Quphoria/PicoDrive/PicoDrive Labelled.png

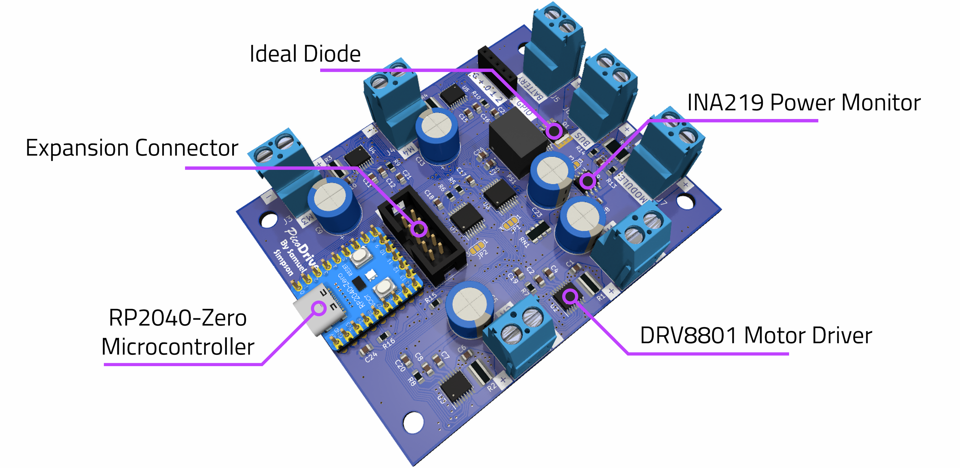
PicoDrive Labelled.png
