Quphoria/PicoDrive/PicoDrive Dark Labelled.png

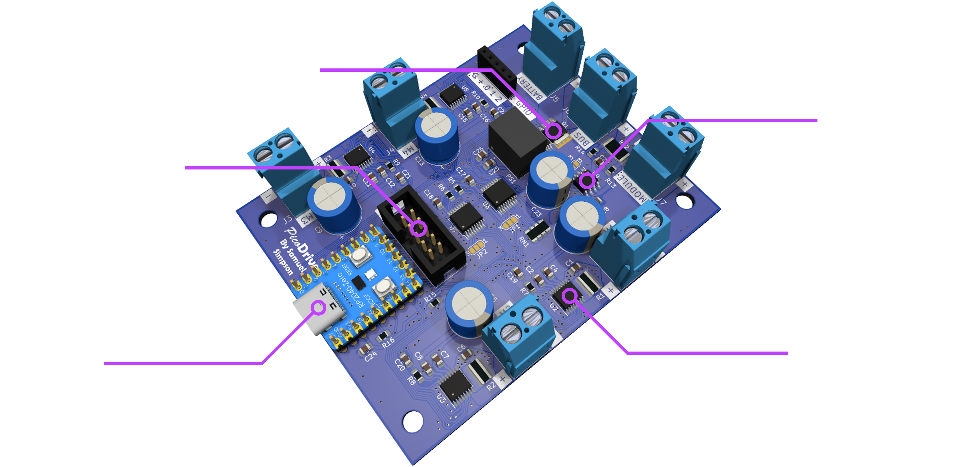
PicoDrive Dark Labelled.png
