Quphoria/PicoDrive/PicoDrive.png

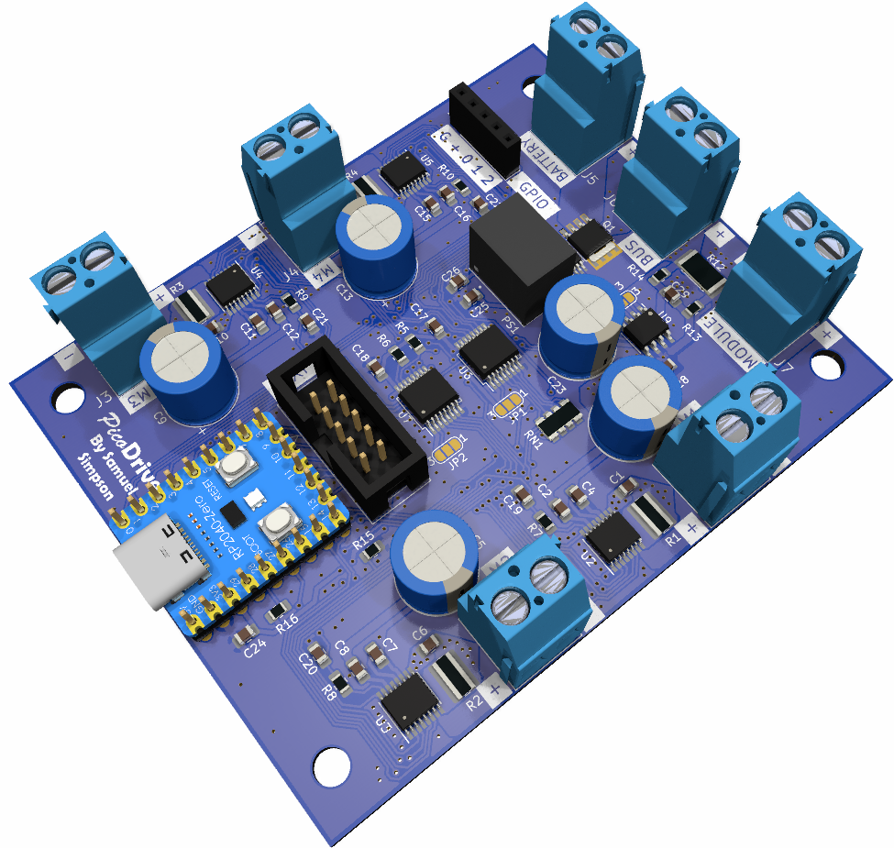
PicoDrive.png
