Quphoria/PicoDrive/PicoDrive.kicad_pcb

## KiCad design PicoDrive.kicad_pcb (2024-04-17)

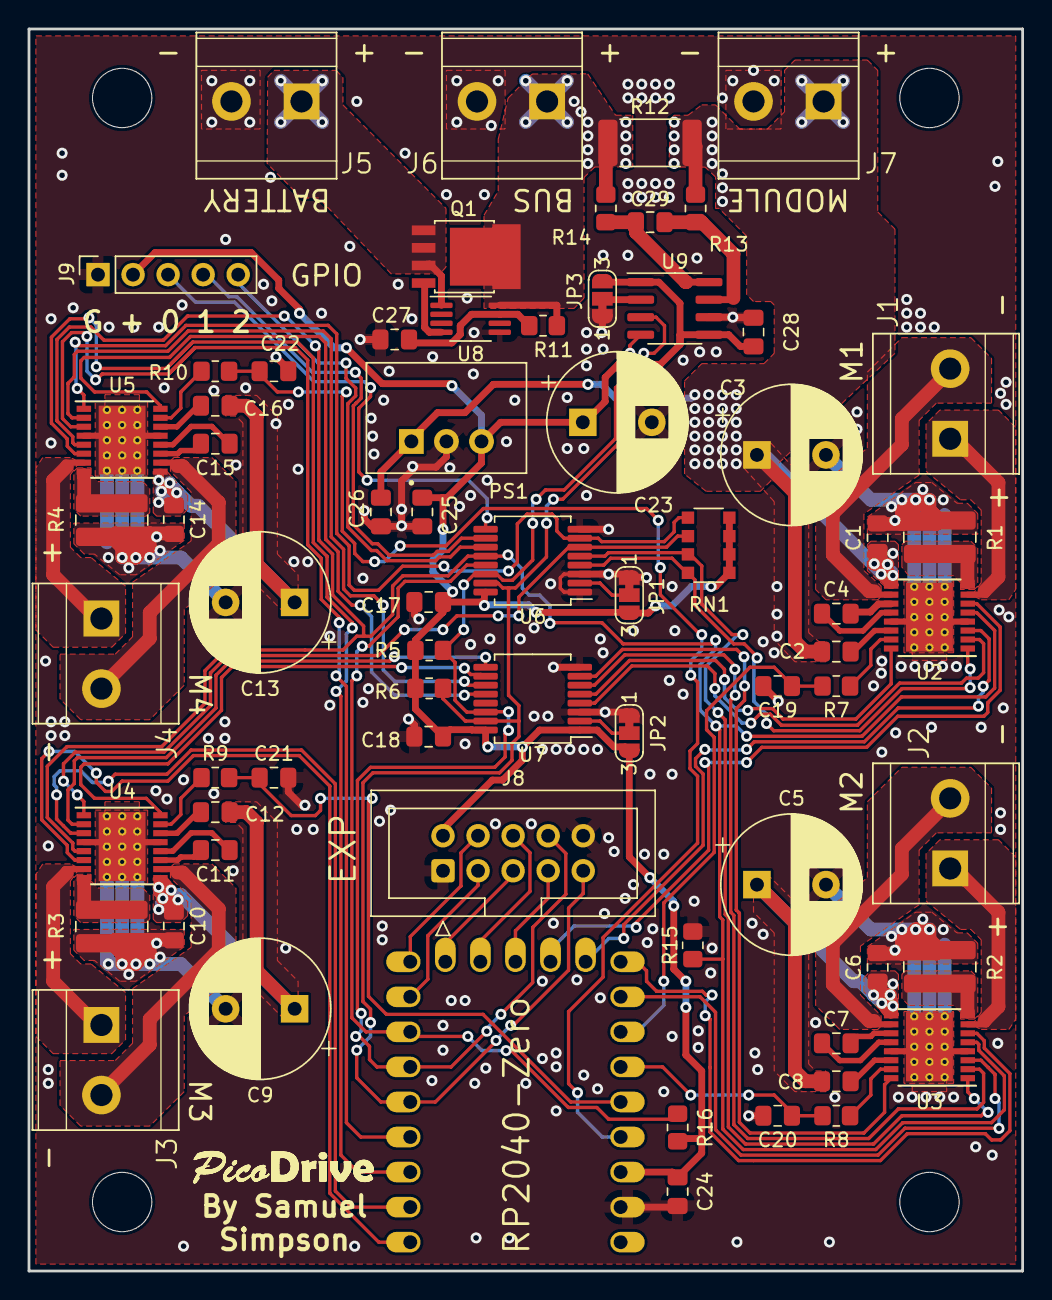
[picture p4: board PicoDrive.kicad_pcb from above]

Board: 2 copper layers, 72.0 x 90.0 mm, 73 parts (0 on the bottom side), 76 nets.

Parts:
C1, C2, C4, C6, C7, C8, C10, C11, C12, C14, C15, C16, C17, C18, C24, C25, C26, C27, C28, C29: 0.1uF; C_0805_2012Metric_Pad1.18x1.45mm_HandSolder
C3, C5, C9, C13, C23: 100uF; CP_Radial_D10.0mm_P5.00mm
C19, C20, C21, C22: 1000pF; C_0805_2012Metric_Pad1.18x1.45mm_HandSolder
H1, H2, H3, H4: MountingHole; MountingHole_4.3mm_M4
J1, J2, J3, J4, J5, J6, J7: Conn_01x02; CUI_TB009-508-02BE
J8: Conn_02x05_Odd_Even; IDC-Header_2x05_P2.54mm_Vertical
J9: Conn_01x05; PinSocket_1x05_P2.54mm_Vertical
JP1, JP2, JP3: SolderJumper_3_Bridged12; SolderJumper-3_P1.3mm_Bridged12_RoundedPad1.0x1.5mm_NumberL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
PS1: P78E03-1000; CONV_P78E03-1000
Q1: PSMN4R5-30YLC; LFPAK56
R1, R2, R3, R4: 0.2; R_1020_2550Metric_Pad1.33x5.20mm_HandSolder
R5, R6: 1.65k; R_0805_2012Metric_Pad1.20x1.40mm_HandSolder
R7, R8, R9, R10, R15, R16: 10k; R_0805_2012Metric_Pad1.20x1.40mm_HandSolder
R11: 100; R_0805_2012Metric_Pad1.20x1.40mm_HandSolder
R12: 0.005; R_2512_6332Metric_Pad1.40x3.35mm_HandSolder
R13, R14: 10; R_0805_2012Metric_Pad1.20x1.40mm_HandSolder
RN1: 10k; R_Array_Convex_4x1206
U1: rp2040-zero; rp2040-zero-tht
U2, U3, U4, U5: DRV8801PWPR; HTSSOP-16-1EP_4.4x5mm_P0.65mm_EP3.4x5mm_Mask3x3mm_ThermalVi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
U6, U7: TCA9554DB; SSOP-16_5.3x6.2mm_P0.65mm
U8: LTC4357MS8; MSOP-8_3x3mm_P0.65mm
U9: INA219BIDR; SOIC-8_3.9x4.9mm_P1.27mm

Connections:
+3V3: C17.1, C18.1, C23.1, C24.2, C25.2, C28.1, J8.2, J9.2, JP1.3 (B), JP2.3 (B), JP3.3 (B), PS1.3 (+VOUT/GND), R5.2, R6.2, R16.2, RN1.1 (R1.1), RN1.2 (R2.1), RN1.3 (R3.1), RN1.4 (R4.1), U1.21 (3V3), U6.16 (VDD), U7.1 (A0), U7.16 (VDD), U9.1 (A1), U9.5 (VS)
+BATT: J5.1, Q1.1 (S), Q1.2 (S), Q1.3 (S), U8.1 (IN)
/EXP_IO_0: J9.3, U6.9 (P4)
/EXP_IO_1: J9.4, U6.10 (P5)
/EXP_IO_2: J9.5, U6.11 (P6)
/EXP_SCL: J8.8, R5.1, U1.6 (5), U6.14 (SCL), U7.14 (SCL), U9.4 (SCL)
/EXP_SDA: J8.9, R6.1, U1.5 (4), U6.15 (SDA), U7.15 (SDA), U9.3 (SDA)
/GPIO7: J8.3, U1.8 (7)
/GPIO8: J8.4, U1.9 (8)
/GPIO9: J8.5, U1.10 (9)
/GPIO10: J8.6, U1.11 (10)
/GPIO11: J8.7, U1.12 (11)
/M1_EN: U1.13 (12), U2.6 (ENABLE)
/M1_MODE1: U2.2 (MODE1), U7.4 (P0)
/M1_MODE2: U2.16 (MODE2), U7.5 (P1)
/M1_PH: U1.14 (13), U2.3 (PHASE)
/M1_VPROPI: C19.2, R7.1, U1.17 (26)
/M2_EN: U1.15 (14), U3.6 (ENABLE)
/M2_MODE1: U3.2 (MODE1), U7.6 (P2)
/M2_MODE2: U3.16 (MODE2), U7.7 (P3)
/M2_PH: U1.16 (15), U3.3 (PHASE)
/M2_VPROPI: C20.2, R8.1, U1.18 (27)
/M3_EN: U1.1 (0), U4.6 (ENABLE)
/M3_MODE1: U4.2 (MODE1), U7.9 (P4)
/M3_MODE2: U4.16 (MODE2), U7.10 (P5)
/M3_PH: U1.2 (1), U4.3 (PHASE)
/M3_VPROPI: C21.2, R9.1, U1.19 (28)
/M4_EN: U1.3 (2), U5.6 (ENABLE)
/M4_MODE1: U5.2 (MODE1), U7.11 (P6)
/M4_MODE2: U5.16 (MODE2), U7.12 (P7)
/M4_PH: U1.4 (3), U5.3 (PHASE)
/M4_VPROPI: C22.2, R10.1, U1.20 (29)
/Motor 1 Driver/OUT+: J1.1, U2.7 (OUT+)
/Motor 1 Driver/OUT-: J1.2, U2.10 (OUT-)
/Motor 1 Driver/SENSE: R1.1, U2.8 (SENSE)
/Motor 2 Driver/OUT+: J2.1, U3.7 (OUT+)
/Motor 2 Driver/OUT-: J2.2, U3.10 (OUT-)
/Motor 2 Driver/SENSE: R2.1, U3.8 (SENSE)
/Motor 3 Driver/OUT+: J3.1, U4.7 (OUT+)
/Motor 3 Driver/OUT-: J3.2, U4.10 (OUT-)
/Motor 3 Driver/SENSE: R3.1, U4.8 (SENSE)
/Motor 4 Driver/OUT+: J4.1, U5.7 (OUT+)
/Motor 4 Driver/OUT-: J4.2, U5.10 (OUT-)
/Motor 4 Driver/SENSE: R4.1, U5.8 (SENSE)
/~EXP1_INT: R16.1, U1.7 (6), U6.13 (~INT)
/~M1_FAULT: RN1.8 (R1.2), U2.1 (~FAULT), U6.4 (P0)
/~M2_FAULT: RN1.7 (R2.2), U3.1 (~FAULT), U6.5 (P1)
/~M3_FAULT: RN1.6 (R3.2), U4.1 (~FAULT), U6.6 (P2)
/~M4_FAULT: RN1.5 (R4.2), U5.1 (~FAULT), U6.7 (P3)
/~M_SLEEP: R15.1, U2.5 (~SLEEP), U3.5 (~SLEEP), U4.5 (~SLEEP), U5.5 (~SLEEP), U6.12 (P7)
GND1: C1.1, C3.2, C5.2, C6.1, C9.2, C10.1, C13.2, C14.1, C17.2, C18.2, C19.1, C20.1, C21.1, C22.1, C23.2, C24.1, C25.1, C26.2, C27.1, C28.2, J5.2, J6.2, J7.2, J8.1, J8.10, J9.1, JP1.1 (A), JP2.1 (A), JP3.1 (A), PS1.2 (GND/-VOUT), R1.2, R2.2, R3.2, R4.2, R15.2, U1.22 (GND), U2.4 (GND), U2.13 (GND), U2.17 (GND(PPAD)), U3.4 (GND), U3.13 (GND), U3.17 (GND(PPAD)), U4.4 (GND), U4.13 (GND), U4.17 (GND(PPAD)), U5.4 (GND), U5.13 (GND), U5.17 (GND(PPAD)), U6.1 (A0), U6.3 (A2), U6.8 (GND), U7.3 (A2), U7.8 (GND), U8.5 (GND), U9.6 (GND)
unnamed: JP1.2 (C), U6.2 (A1)
unnamed: JP2.2 (C), U7.2 (A1)
unnamed: JP3.2 (C), U9.2 (A0)
unnamed: Q1.4 (G), U8.4 (GATE)
unnamed: C4.2, U2.11 (CP1)
unnamed: C4.1, U2.12 (CP2)
unnamed: C2.2, U2.14 (VCP)
unnamed: R7.2, U2.15 (VPROPI)
unnamed: C7.2, U3.11 (CP1)
unnamed: C7.1, U3.12 (CP2)
unnamed: C8.2, U3.14 (VCP)
unnamed: R8.2, U3.15 (VPROPI)
unnamed: C11.2, U4.11 (CP1)
unnamed: C11.1, U4.12 (CP2)
unnamed: C12.2, U4.14 (VCP)
unnamed: R9.2, U4.15 (VPROPI)
unnamed: C15.2, U5.11 (CP1)
unnamed: C15.1, U5.12 (CP2)
unnamed: C16.2, U5.14 (VCP)
unnamed: R10.2, U5.15 (VPROPI)
unnamed: C27.2, R11.1, U8.7 (Vdd)
unnamed: C29.1, R14.2, U9.8 (IN+)
unnamed: C29.2, R13.2, U9.7 (IN-)
VBUS: J6.1, Q1.5 (D), R11.2, R12.1, R14.1, U8.8 (OUT)
Vdrive: C1.2, C2.1, C3.1, C5.1, C6.2, C8.1, C9.1, C10.2, C12.1, C13.1, C14.2, C16.1, C26.1, J7.1, PS1.1 (+VIN), R12.2, R13.1, U2.9 (VBB), U3.9 (VBB), U4.9 (VBB), U5.9 (VBB)
