Quphoria/PicoDrive/(commit log)

2024-03-31 Add 10k pulldown to nSleep and export BOM
    [BioRobotics Tank PCB.csv, BioRobotics Tank PCB.kicad_pcb, BioRobotics Tank PCB.kicad_sch, Motor Driver.kicad_sch]
2024-03-31 Update 0.1uF capacitor mfr no
    [BioRobotics Tank PCB.csv, BioRobotics Tank PCB.kicad_pcb, BioRobotics Tank PCB.kicad_sch, Motor Driver.kicad_sch]
2024-03-31 Change to product number to PCBWays template
    [BioRobotics Tank PCB.kicad_pcb]
2024-03-31 Move some silkscreen items
    [BioRobotics Tank PCB.kicad_pcb]
2024-03-31 Change Screw Terminal Part and update Mfr No's
    [BioRobotics Tank PCB.csv, BioRobotics Tank PCB.kicad_pcb, BioRobotics Tank PCB.kicad_sch, Motor Driver.kicad_sch]
2024-03-31 Increase DC-DC converter pad size
    [BioRobotics Tank PCB.kicad_pcb]
2024-03-31 Increase Mosfet pad size
    [BioRobotics Tank PCB.kicad_pcb]
2024-03-31 Generate PCBWay production files
    [BioRobotics Tank PCB.kicad_pcb, BioRobotics Tank PCB.kicad_pcb_bom.csv, BioRobotics Tank PCB.kicad_pcb_positions.csv]
2024-04-01 Change ideal diode mosfet and increase track sizes
    [BioRobotics Tank PCB.csv, BioRobotics Tank PCB.kicad_pcb, BioRobotics Tank PCB.kicad_pcb_bom.csv, BioRobotics Tank PCB.kicad_pcb_positions.csv, BioRobotics Tank PCB.kicad_sch]
2024-04-01 Remove unused kicad library
2024-04-01 Add via's around power connectors to improve current capacity
    [BioRobotics Tank PCB.kicad_pcb, BioRobotics Tank PCB.kicad_pcb_bom.csv, BioRobotics Tank PCB.kicad_pcb_positions.csv]
2024-04-01 Increase ground connection trace to motor drivers
    [BioRobotics Tank PCB.kicad_pcb, BioRobotics Tank PCB.kicad_pcb_bom.csv, BioRobotics Tank PCB.kicad_pcb_positions.csv]
2024-04-01 Copy extra ground trace for drivers to top layer
    [BioRobotics Tank PCB.kicad_pcb, BioRobotics Tank PCB.kicad_pcb_bom.csv, BioRobotics Tank PCB.kicad_pcb_positions.csv]
2024-04-01 Move some via's to improve routing / ground width
    [BioRobotics Tank PCB.kicad_pcb, BioRobotics Tank PCB.kicad_pcb_bom.csv, BioRobotics Tank PCB.kicad_pcb_positions.csv]
2024-04-01 Improve ground connection over Vdrive trace
    [BioRobotics Tank PCB.kicad_pcb, BioRobotics Tank PCB.kicad_pcb_bom.csv, BioRobotics Tank PCB.kicad_pcb_positions.csv]
2024-04-02 Add mouser no's, pullup resistor, change project name
    [BioRobotics Tank PCB.csv, Motor Driver.kicad_sch, PicoDrive.csv, PicoDrive.kicad_pcb, PicoDrive.kicad_pcb_bom.csv, PicoDrive.kicad_pcb_positions.csv, PicoDrive.kicad_sch]
2024-04-17 Fix io expander component to match footprint
    [PicoDrive.csv, PicoDrive.kicad_sch]
2024-04-17 Fix mfault pullup resistor (it was configured as a pulldown)
    [PicoDrive.kicad_pcb, PicoDrive.kicad_pcb_bom.csv, PicoDrive.kicad_pcb_positions.csv, PicoDrive.kicad_sch]
